Muhammad-Alli/4-20mA-current-source-generator/Hardware/Block Diagram.pdf

### Block Diagram

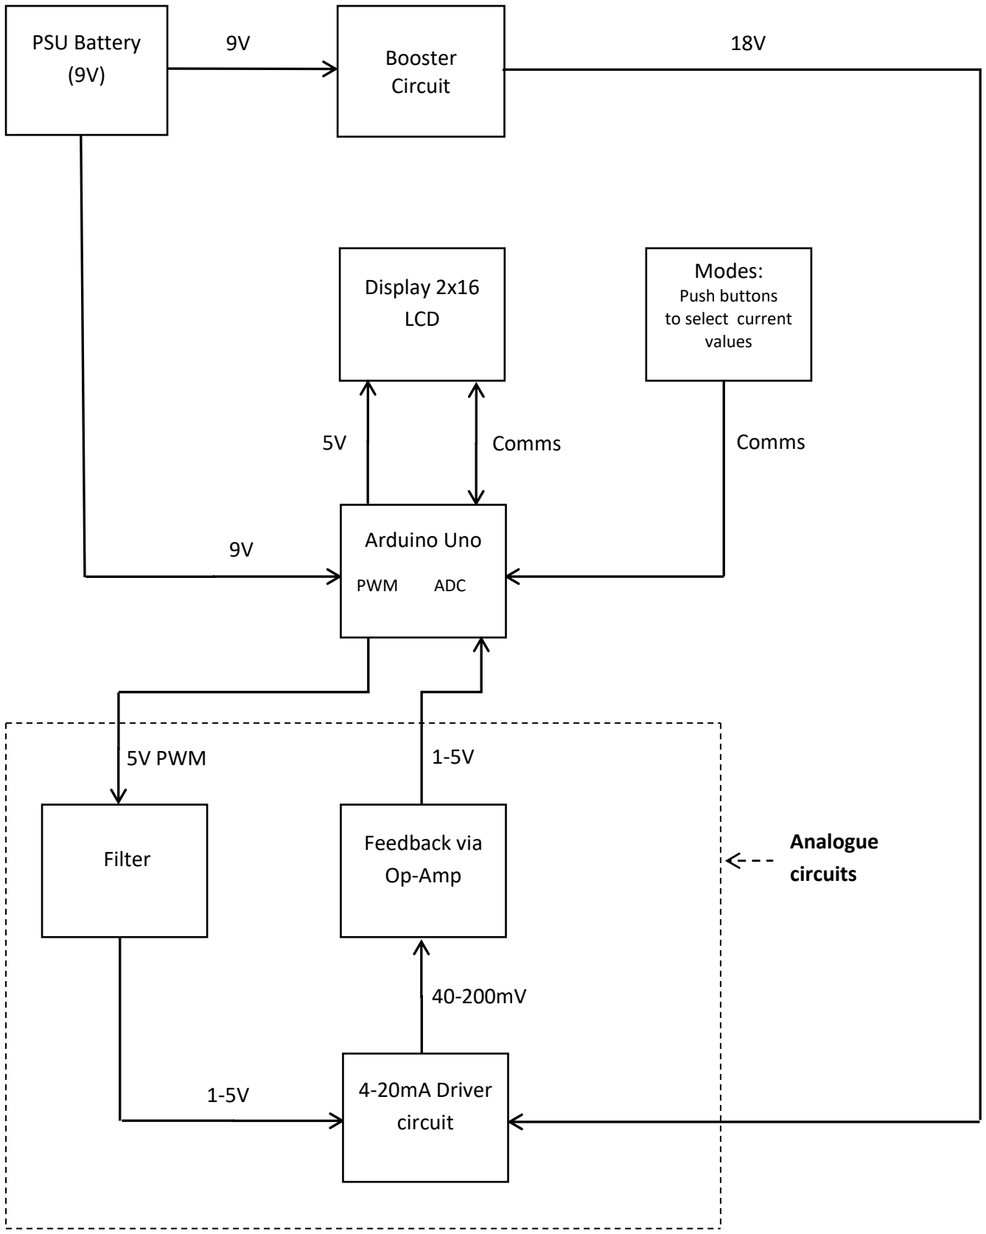
[picture p1: figure]
PSU Battery (9V); Booster Circuit; Arduino Uno; PWM; ADC; Display 2x16 LCD; 5V PWM; Modes: Push buttons to select current values; Comms; Feedback via Op-Amp; Filter; Analogue circuits; 4-20mA Driver circuit
