Muhammad-Alli/4-20mA-current-source-generator/Hardware/Circuit Diagram.pdf

# Circuit Diagram

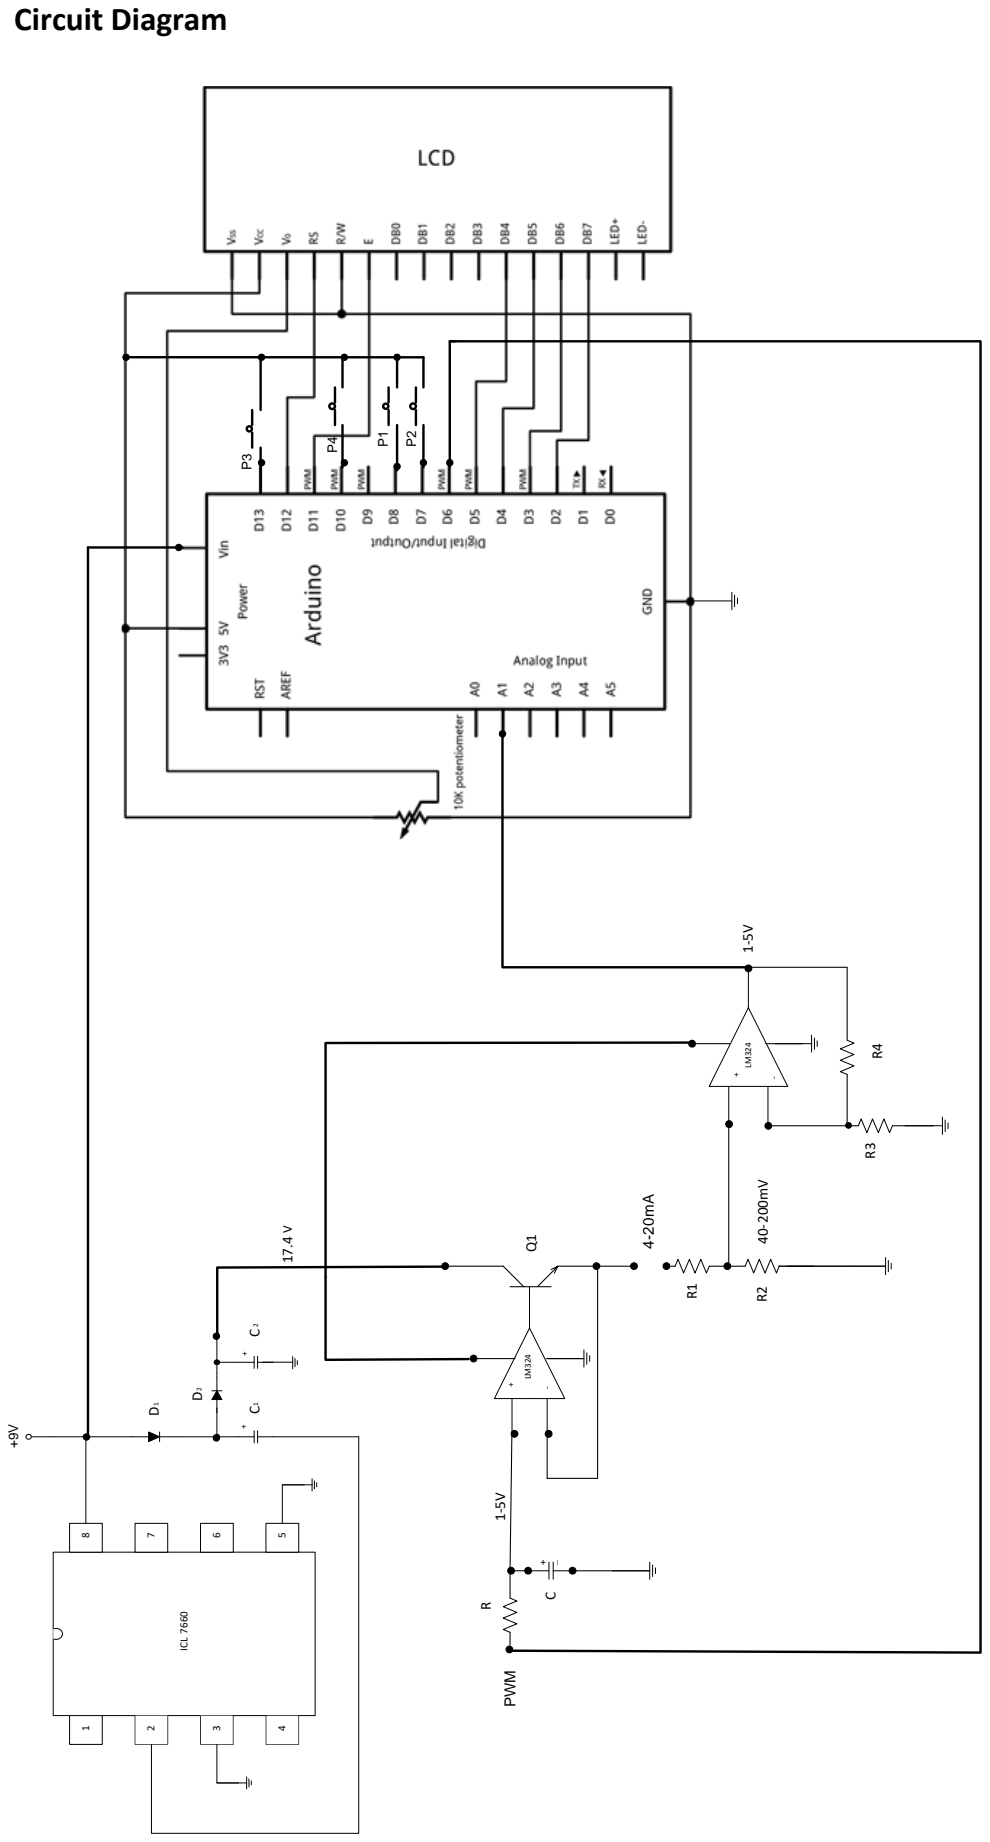
[picture p10: page 1]
