Muhammad-Alli/4-20mA-current-source-generator/Docs/Project Results.pdf

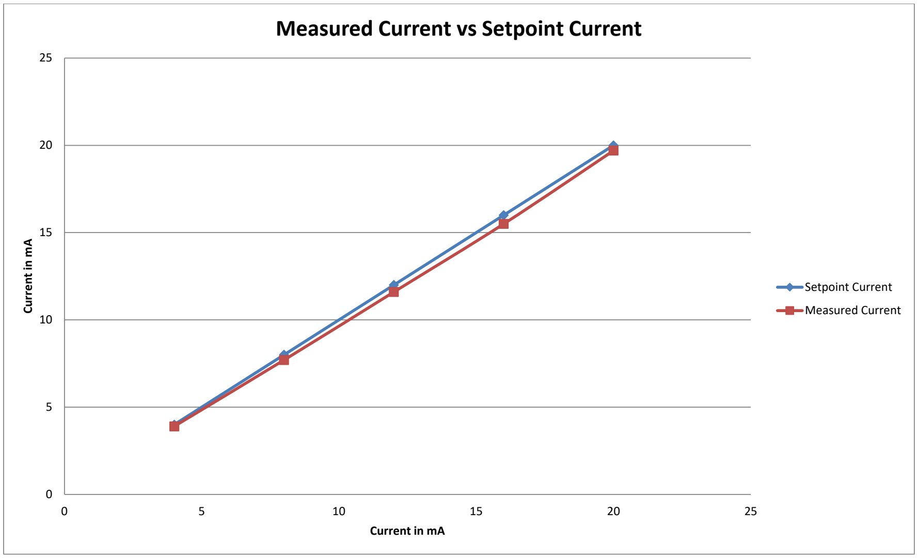
[picture p11: figure]
Current in mA; Measured Current vs Setpoint Current; Setpoint Current; Measured Current
